squadracorsepolito/SCanner/(threads)

Thread 1 (2024-04-12):

Hardware issues to be fixed in v1

federico-carbone, 2024-04-12:
- [x] pulldown BOOT0
- [x] fix VCAP connections to the uC
- [x] fix nINTSEL selection for LAN8742AI (section 3.8.1.6, nINTSEL=0)
- [x] rotate 180° the SD slot
- [x] fix placement of eth connector (must be more external)
- [x] self-kill mosfet not working (cannot be controlled with 3v3)

Closed 2024-05-06.
