squadracorsepolito/SCanner/docs/schematics_v1.pdf

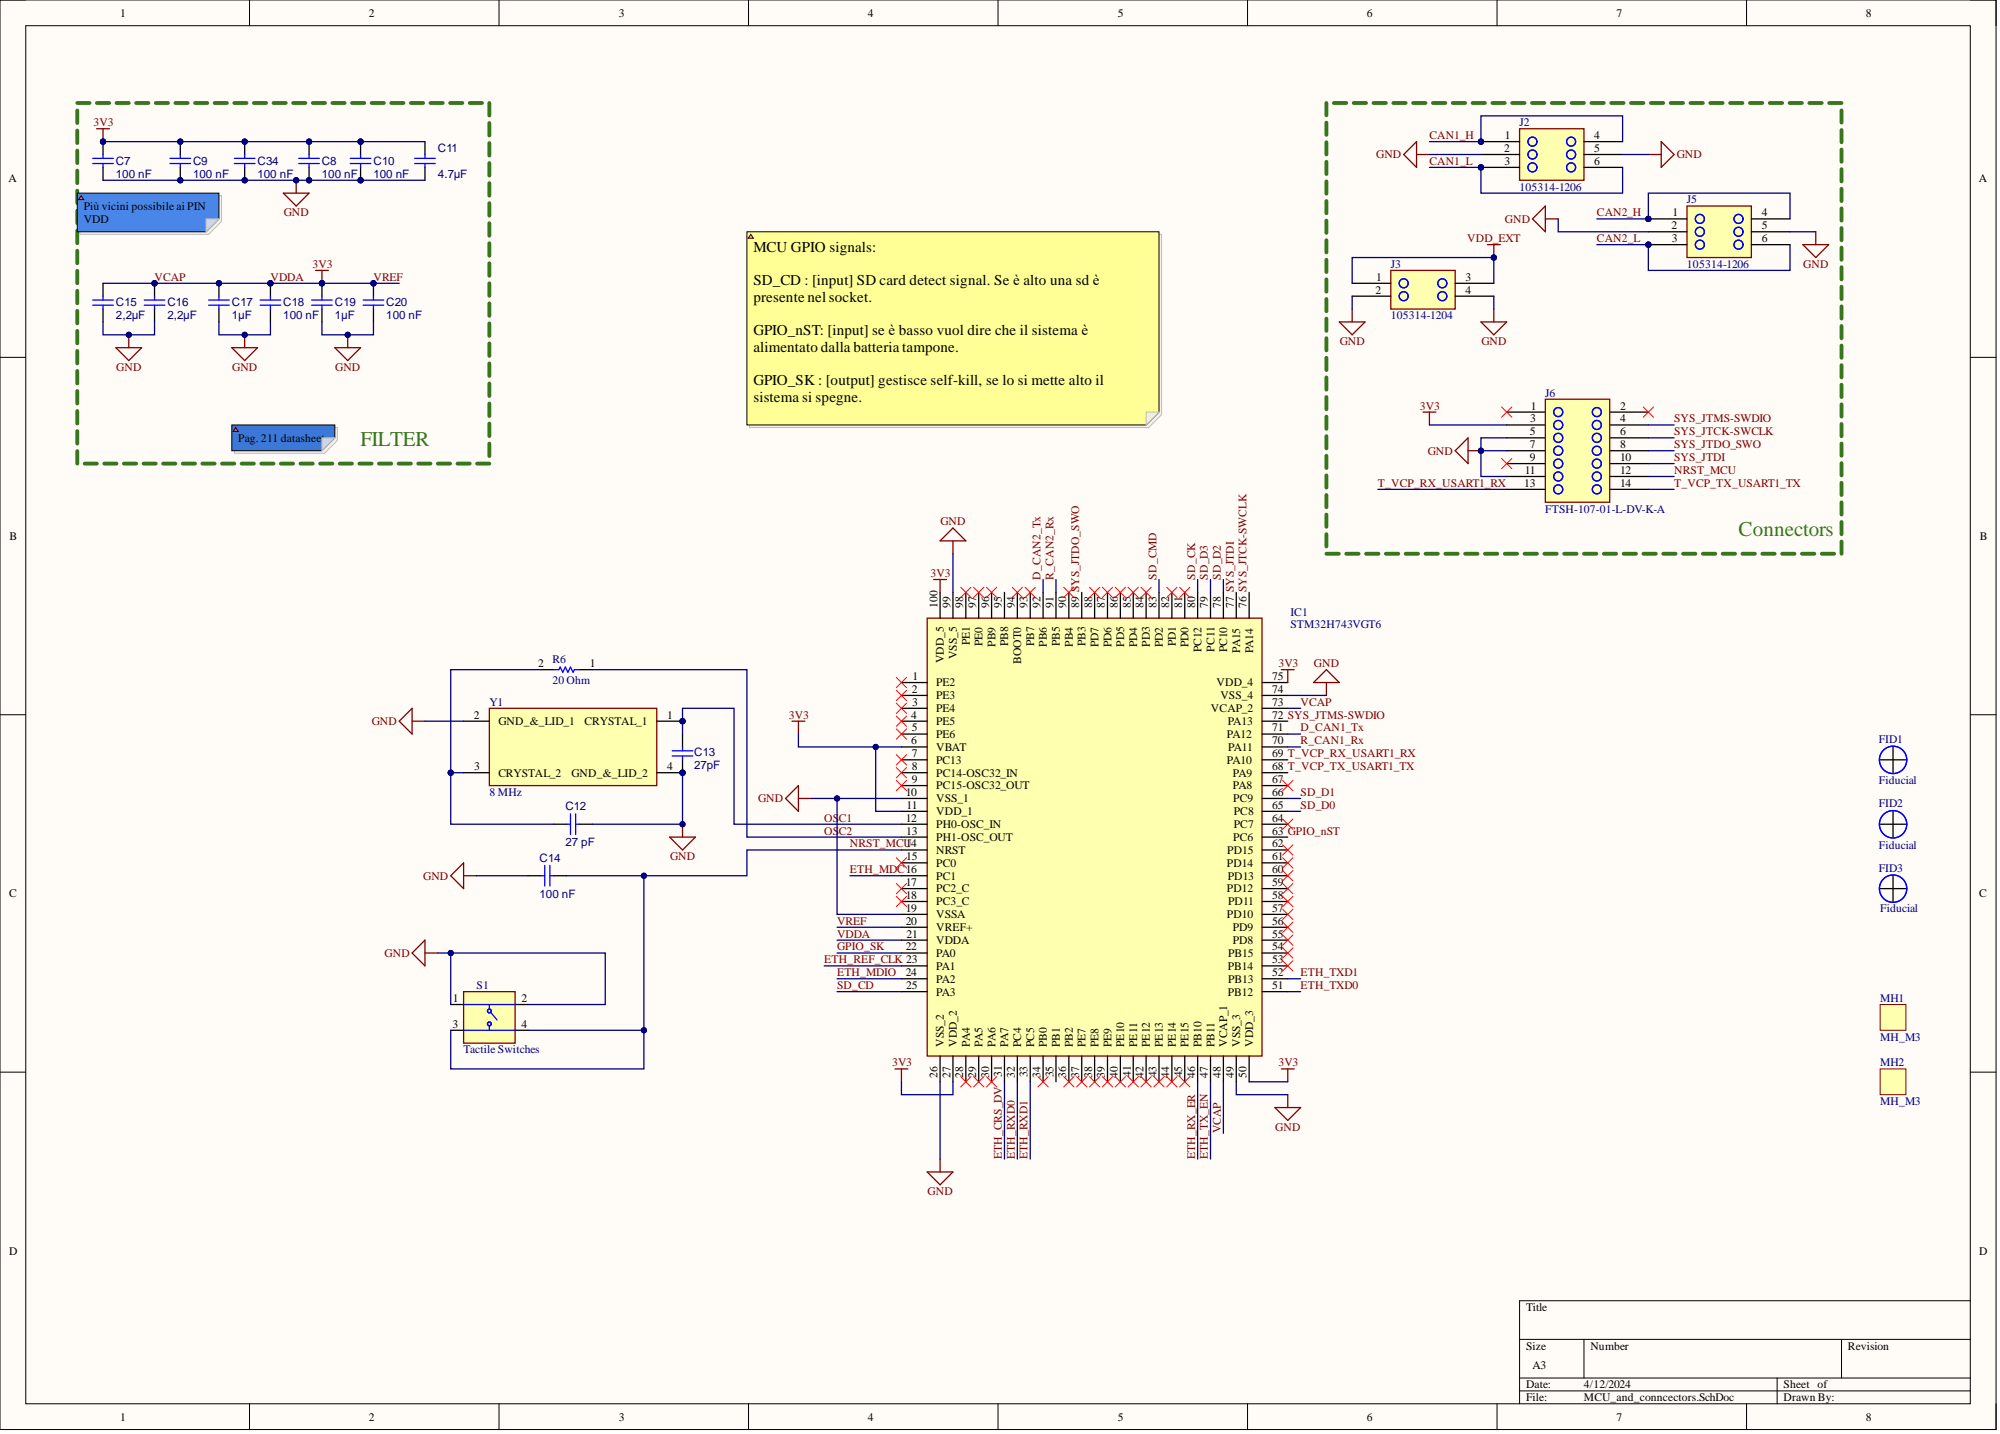
[picture p1: page 1]

Più vicini possibile ai PIN
VDD

SD_CD : [input] SD card detect signal. Se è alto una sd è
presente nel socket.

GPIO_nST: [input] se è basso vuol dire che il sistema è
alimentato dalla batteria tampone.

GPIO_SK : [output] gestisce self-kill, se lo si mette alto il
sistema si spegne.

VDD_1 11

OSC2 | | PH1-OSC_OUT 13
NRST_MCU | NRST 14

GND | ETH_MDC | | PC0 15

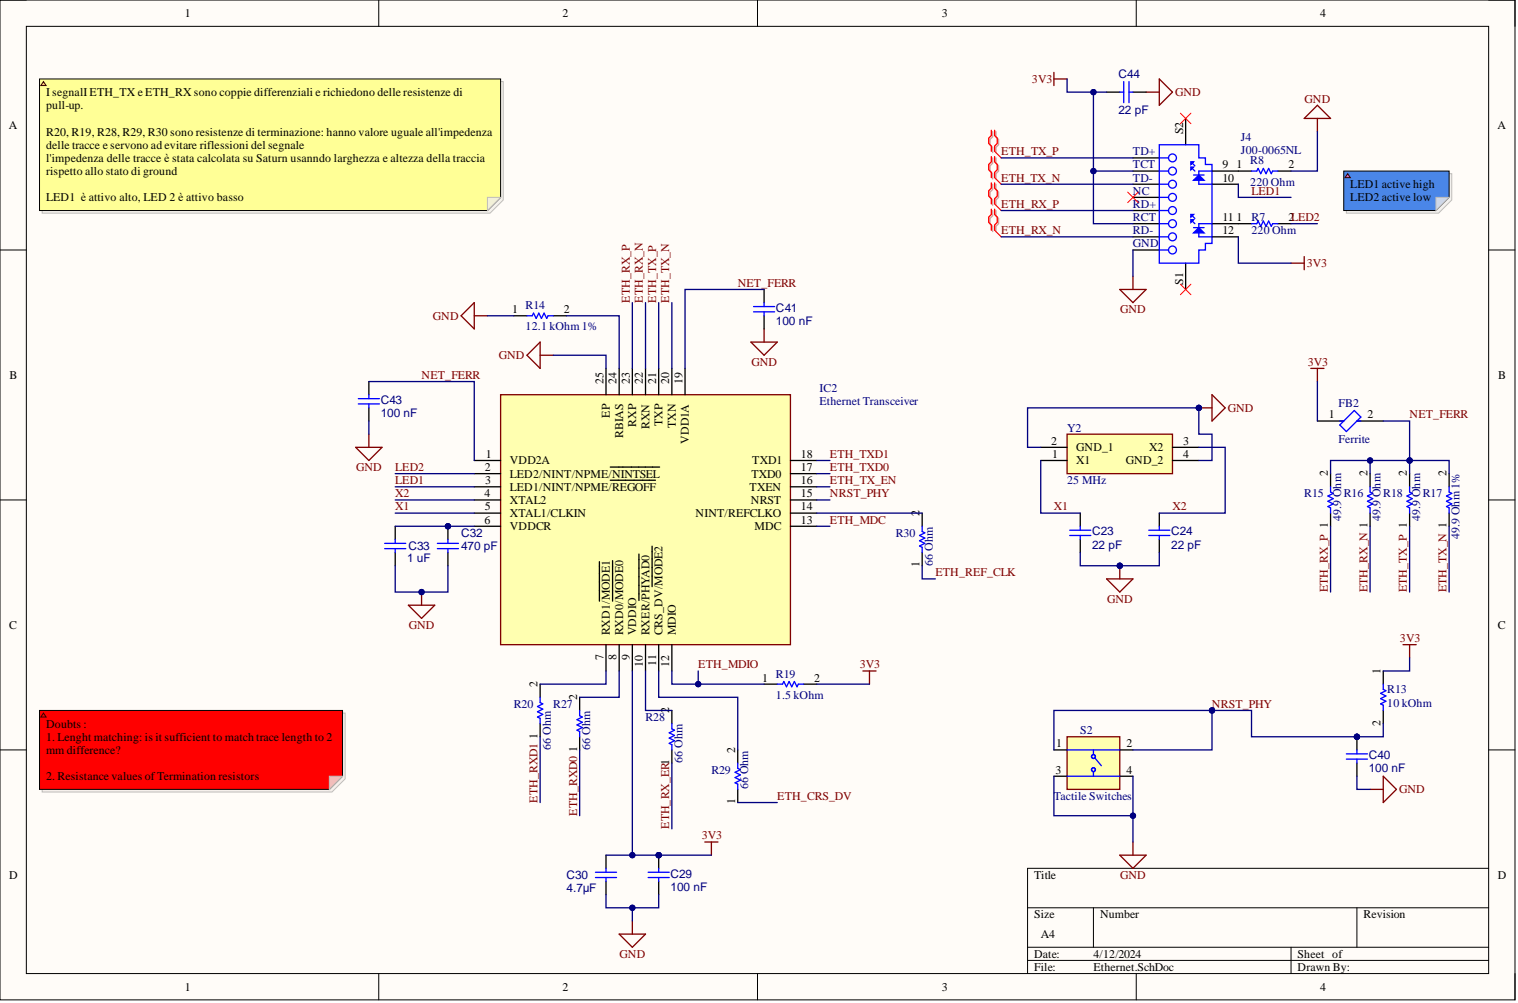
[picture p2: page 2]

I segnalI ETH_TX e ETH_RX sono coppie differenziali e richiedono delle resistenze di
pull-up.

R20, R19, R28, R29, R30 sono resistenze di terminazione: hanno valore uguale all'impedenza
delle tracce e servono ad evitare riflessioni delsegnale
l'impedenza delle tracce è stata calcolata su Saturn usanndo larghezza e altezza della traccia
rispetto allo stato di ground

LED1 è attivo alto, LED 2 è attivo basso

LED1

Doubts :
1. Lenght matching: is it sufficient to match trace length to 2
mm difference?

2. Resistance values of Termination resistors

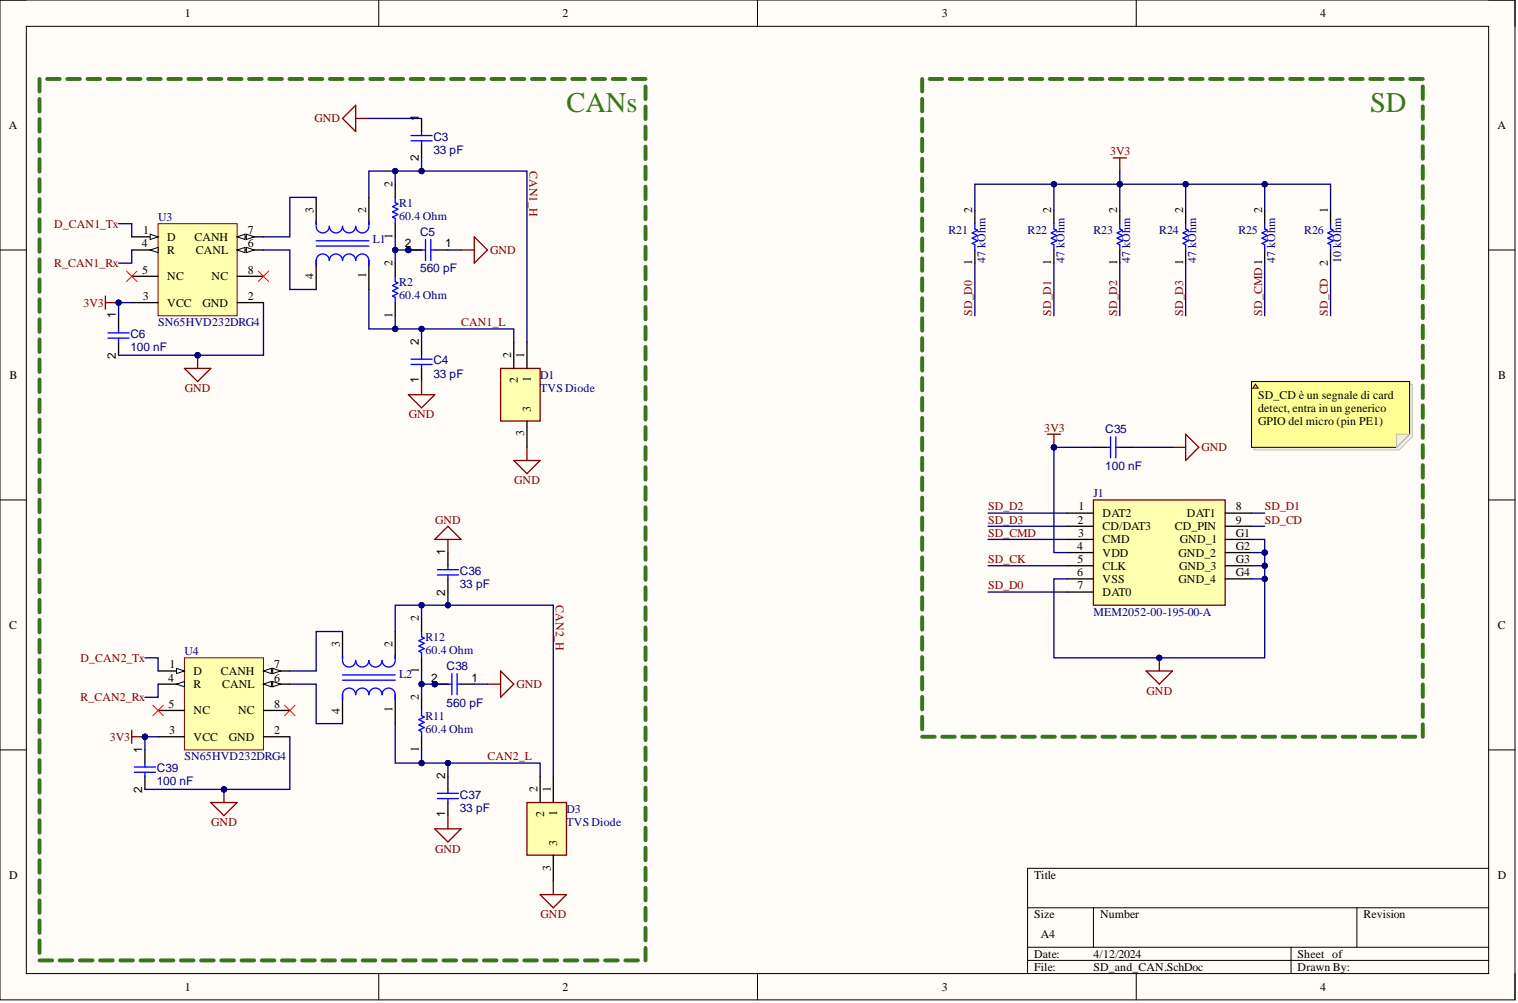
[picture p3: page 3]
47 kOhm; 10 kOhm; 6 CANH; CANs; SD GND C35; i card; detect, en del micro (p

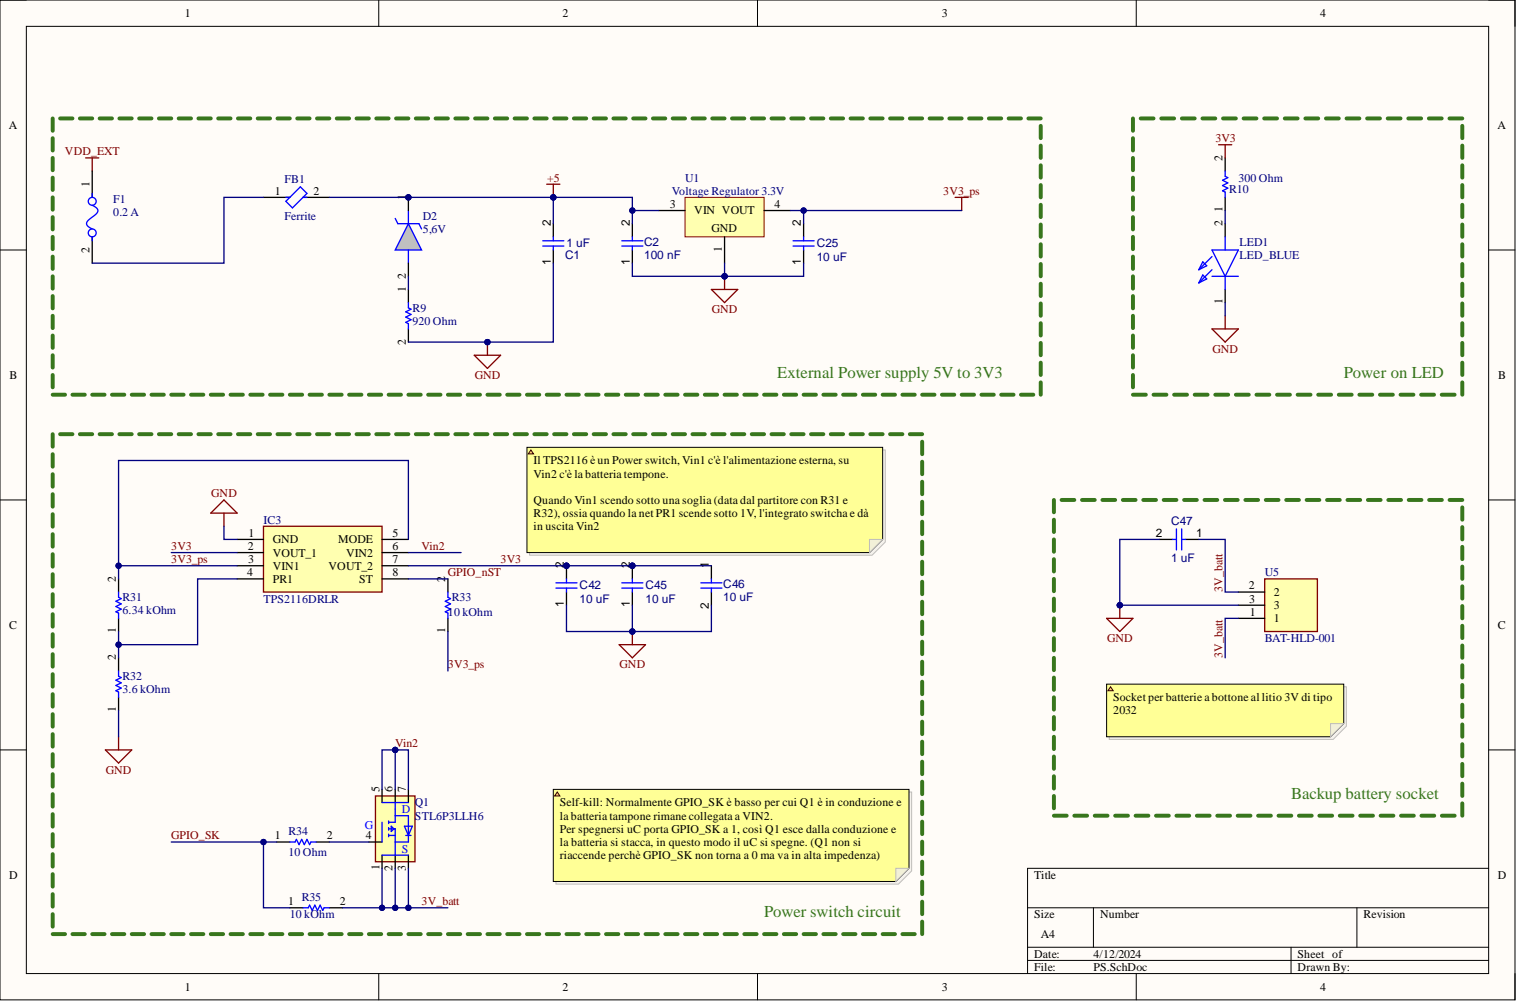
[picture p4: page 4]

Il TPS2116 è un Power switch, Vin1 c'è l'alimentazione esterna, su
Vin2 c'è la batteria tempone.

Quando Vin1 scendo sotto una soglia (data dal partitore con R31 e
R32), ossia quando la net PR1 scende sotto 1V, l'integrato switcha e dà
in uscita Vin2

Socket per batterie a bottone al litio 3V di tipo

Self-kill: Normalmente GPIO_SK è basso per cui Q1 è in conduzione e
la batteria tampone rimane collegata a VIN2.
Per spegnersi uC porta GPIO_SK a 1, così Q1 esce dalla conduzione e
la batteria si stacca, in questo modo il uC si spegne. (Q1 non si
riaccende perchè GPIO_SK non torna a 0 ma va in alta impedenza)

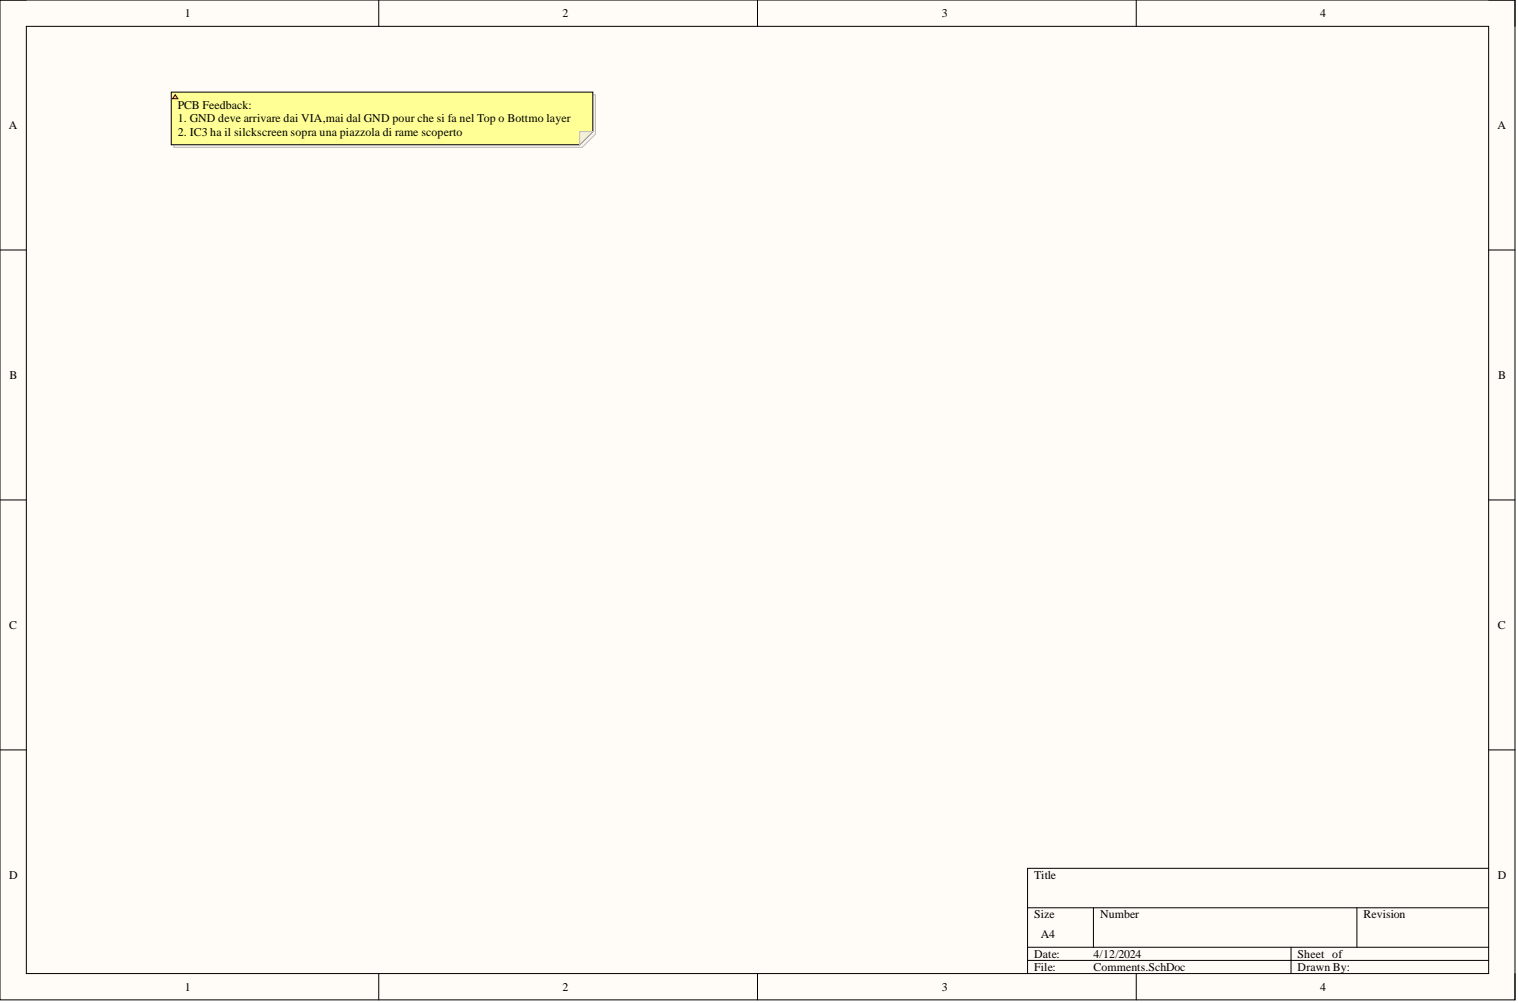
[picture p5: page 5]
File:; Comments.SchDoc; Drawn By:

PCB Feedback:
1. GND deve arrivare dai VIA,mai dal GND pour che si fa nel Top o Bottmo layer
2. IC3 ha il silckscreen sopra una piazzola di rame scoperto
