squadracorsepolito/SCanner/Core/Inc/main.h

#define LWIP_Init_Done 0x1
#define SDCARD_Init_Done 0x2
#define SELF_KILL_Pin GPIO_PIN_0
#define SELF_KILL_GPIO_Port GPIOA
#define SD_DET_Pin GPIO_PIN_3
#define SD_DET_GPIO_Port GPIOA
#define nRST_PHY_GPIO_OUT_Pin GPIO_PIN_15
#define nRST_PHY_GPIO_OUT_GPIO_Port GPIOB
#define GPIO_nST_Pin GPIO_PIN_6
#define GPIO_nST_GPIO_Port GPIOC
#define GPIO_nST_EXTI_IRQn EXTI9_5_IRQn
