squadracorsepolito/SCanner/Core/Src/fdcan.c

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
/* Includes ------------------------------------------------------------------*/
#include "fdcan.h"

FDCAN_HandleTypeDef hfdcan1;
FDCAN_HandleTypeDef hfdcan2;

/* FDCAN1 init function */
void MX_FDCAN1_Init(void)
{

  hfdcan1.Instance = FDCAN1;
  hfdcan1.Init.FrameFormat = FDCAN_FRAME_CLASSIC;
  hfdcan1.Init.Mode = FDCAN_MODE_BUS_MONITORING;
  hfdcan1.Init.AutoRetransmission = DISABLE;
  hfdcan1.Init.TransmitPause = DISABLE;
  hfdcan1.Init.ProtocolException = DISABLE;
  hfdcan1.Init.NominalPrescaler = 1;
  hfdcan1.Init.NominalSyncJumpWidth = 13;
  hfdcan1.Init.NominalTimeSeg1 = 86;
  hfdcan1.Init.NominalTimeSeg2 = 13;
  hfdcan1.Init.DataPrescaler = 10;
  hfdcan1.Init.DataSyncJumpWidth = 1;
  hfdcan1.Init.DataTimeSeg1 = 8;
  hfdcan1.Init.DataTimeSeg2 = 1;
  hfdcan1.Init.MessageRAMOffset = 0;
  hfdcan1.Init.StdFiltersNbr = 1;
  hfdcan1.Init.ExtFiltersNbr = 0;
  hfdcan1.Init.RxFifo0ElmtsNbr = 64;
  hfdcan1.Init.RxFifo0ElmtSize = FDCAN_DATA_BYTES_8;
  hfdcan1.Init.RxFifo1ElmtsNbr = 0;
  hfdcan1.Init.RxFifo1ElmtSize = FDCAN_DATA_BYTES_8;
  hfdcan1.Init.RxBuffersNbr = 0;
  hfdcan1.Init.RxBufferSize = FDCAN_DATA_BYTES_8;
  hfdcan1.Init.TxEventsNbr = 0;
  hfdcan1.Init.TxBuffersNbr = 0;
  hfdcan1.Init.TxFifoQueueElmtsNbr = 32;
  hfdcan1.Init.TxFifoQueueMode = FDCAN_TX_FIFO_OPERATION;
  hfdcan1.Init.TxElmtSize = FDCAN_DATA_BYTES_8;
  if (HAL_FDCAN_Init(&hfdcan1) != HAL_OK)
  {
    Error_Handler();
  }
}
/* FDCAN2 init function */
void MX_FDCAN2_Init(void)
{

  hfdcan2.Instance = FDCAN2;
  hfdcan2.Init.FrameFormat = FDCAN_FRAME_CLASSIC;
  hfdcan2.Init.Mode = FDCAN_MODE_BUS_MONITORING;
  hfdcan2.Init.AutoRetransmission = DISABLE;
  hfdcan2.Init.TransmitPause = DISABLE;
  hfdcan2.Init.ProtocolException = DISABLE;
  hfdcan2.Init.NominalPrescaler = 1;
  hfdcan2.Init.NominalSyncJumpWidth = 1;
  hfdcan2.Init.NominalTimeSeg1 = 86;
  hfdcan2.Init.NominalTimeSeg2 = 13;
  hfdcan2.Init.DataPrescaler = 10;
  hfdcan2.Init.DataSyncJumpWidth = 1;
  hfdcan2.Init.DataTimeSeg1 = 8;
  hfdcan2.Init.DataTimeSeg2 = 1;
  hfdcan2.Init.MessageRAMOffset = 385;
  hfdcan2.Init.StdFiltersNbr = 1;
  hfdcan2.Init.ExtFiltersNbr = 0;
  hfdcan2.Init.RxFifo0ElmtsNbr = 0;
  hfdcan2.Init.RxFifo0ElmtSize = FDCAN_DATA_BYTES_8;
  hfdcan2.Init.RxFifo1ElmtsNbr = 64;
  hfdcan2.Init.RxFifo1ElmtSize = FDCAN_DATA_BYTES_8;
  hfdcan2.Init.RxBuffersNbr = 0;
  hfdcan2.Init.RxBufferSize = FDCAN_DATA_BYTES_8;
  hfdcan2.Init.TxEventsNbr = 0;
  hfdcan2.Init.TxBuffersNbr = 0;
  hfdcan2.Init.TxFifoQueueElmtsNbr = 32;
  hfdcan2.Init.TxFifoQueueMode = FDCAN_TX_FIFO_OPERATION;
  hfdcan2.Init.TxElmtSize = FDCAN_DATA_BYTES_8;
  if (HAL_FDCAN_Init(&hfdcan2) != HAL_OK)
  {
    Error_Handler();
  }
}

static uint32_t HAL_RCC_FDCAN_CLK_ENABLED=0;

void HAL_FDCAN_MspInit(FDCAN_HandleTypeDef* fdcanHandle)
{

  GPIO_InitTypeDef GPIO_InitStruct = {0};
  RCC_PeriphCLKInitTypeDef PeriphClkInitStruct = {0};
  if(fdcanHandle->Instance==FDCAN1)
  {
  /** Initializes the peripherals clock
  */
    PeriphClkInitStruct.PeriphClockSelection = RCC_PERIPHCLK_FDCAN;
    PeriphClkInitStruct.FdcanClockSelection = RCC_FDCANCLKSOURCE_PLL;
    if (HAL_RCCEx_PeriphCLKConfig(&PeriphClkInitStruct) != HAL_OK)
    {
      Error_Handler();
    }

    /* FDCAN1 clock enable */
    HAL_RCC_FDCAN_CLK_ENABLED++;
    if(HAL_RCC_FDCAN_CLK_ENABLED==1){
      __HAL_RCC_FDCAN_CLK_ENABLE();
    }

    __HAL_RCC_GPIOA_CLK_ENABLE();
    /**FDCAN1 GPIO Configuration
    PA11     ------> FDCAN1_RX
    PA12     ------> FDCAN1_TX
    */
    GPIO_InitStruct.Pin = GPIO_PIN_11|GPIO_PIN_12;
    GPIO_InitStruct.Mode = GPIO_MODE_AF_PP;
    GPIO_InitStruct.Pull = GPIO_NOPULL;
    GPIO_InitStruct.Speed = GPIO_SPEED_FREQ_LOW;
    GPIO_InitStruct.Alternate = GPIO_AF9_FDCAN1;
    HAL_GPIO_Init(GPIOA, &GPIO_InitStruct);

    /* FDCAN1 interrupt Init */
    HAL_NVIC_SetPriority(FDCAN1_IT0_IRQn, 5, 0);
    HAL_NVIC_EnableIRQ(FDCAN1_IT0_IRQn);
    HAL_NVIC_SetPriority(FDCAN1_IT1_IRQn, 5, 0);
    HAL_NVIC_EnableIRQ(FDCAN1_IT1_IRQn);
    HAL_NVIC_SetPriority(FDCAN_CAL_IRQn, 5, 0);
    HAL_NVIC_EnableIRQ(FDCAN_CAL_IRQn);
  }
  else if(fdcanHandle->Instance==FDCAN2)
  {
  /** Initializes the peripherals clock
  */
    PeriphClkInitStruct.PeriphClockSelection = RCC_PERIPHCLK_FDCAN;
    PeriphClkInitStruct.FdcanClockSelection = RCC_FDCANCLKSOURCE_PLL;
    if (HAL_RCCEx_PeriphCLKConfig(&PeriphClkInitStruct) != HAL_OK)
    {
      Error_Handler();
    }

    /* FDCAN2 clock enable */
    HAL_RCC_FDCAN_CLK_ENABLED++;
    if(HAL_RCC_FDCAN_CLK_ENABLED==1){
      __HAL_RCC_FDCAN_CLK_ENABLE();
    }

    __HAL_RCC_GPIOB_CLK_ENABLE();
    /**FDCAN2 GPIO Configuration
    PB5     ------> FDCAN2_RX
    PB6     ------> FDCAN2_TX
    */
    GPIO_InitStruct.Pin = GPIO_PIN_5|GPIO_PIN_6;
    GPIO_InitStruct.Mode = GPIO_MODE_AF_PP;
    GPIO_InitStruct.Pull = GPIO_NOPULL;
    GPIO_InitStruct.Speed = GPIO_SPEED_FREQ_LOW;
    GPIO_InitStruct.Alternate = GPIO_AF9_FDCAN2;
    HAL_GPIO_Init(GPIOB, &GPIO_InitStruct);

    /* FDCAN2 interrupt Init */
    HAL_NVIC_SetPriority(FDCAN2_IT0_IRQn, 5, 0);
    HAL_NVIC_EnableIRQ(FDCAN2_IT0_IRQn);
    HAL_NVIC_SetPriority(FDCAN2_IT1_IRQn, 5, 0);
    HAL_NVIC_EnableIRQ(FDCAN2_IT1_IRQn);
    HAL_NVIC_SetPriority(FDCAN_CAL_IRQn, 5, 0);
    HAL_NVIC_EnableIRQ(FDCAN_CAL_IRQn);
  }
}

void HAL_FDCAN_MspDeInit(FDCAN_HandleTypeDef* fdcanHandle)
{

  if(fdcanHandle->Instance==FDCAN1)
  {
    /* Peripheral clock disable */
    HAL_RCC_FDCAN_CLK_ENABLED--;
    if(HAL_RCC_FDCAN_CLK_ENABLED==0){
      __HAL_RCC_FDCAN_CLK_DISABLE();
    }

    /**FDCAN1 GPIO Configuration
    PA11     ------> FDCAN1_RX
    PA12     ------> FDCAN1_TX
    */
    HAL_GPIO_DeInit(GPIOA, GPIO_PIN_11|GPIO_PIN_12);

    /* FDCAN1 interrupt Deinit */
    HAL_NVIC_DisableIRQ(FDCAN1_IT0_IRQn);
    HAL_NVIC_DisableIRQ(FDCAN1_IT1_IRQn);
  /* USER CODE BEGIN FDCAN1:FDCAN_CAL_IRQn disable */
    /**
    * Uncomment the line below to disable the "FDCAN_CAL_IRQn" interrupt
    * Be aware, disabling shared interrupt may affect other IPs
    */
    /* HAL_NVIC_DisableIRQ(FDCAN_CAL_IRQn); */
  /* USER CODE END FDCAN1:FDCAN_CAL_IRQn disable */

  }
  else if(fdcanHandle->Instance==FDCAN2)
  {
    /* Peripheral clock disable */
    HAL_RCC_FDCAN_CLK_ENABLED--;
    if(HAL_RCC_FDCAN_CLK_ENABLED==0){
      __HAL_RCC_FDCAN_CLK_DISABLE();
    }

    /**FDCAN2 GPIO Configuration
    PB5     ------> FDCAN2_RX
    PB6     ------> FDCAN2_TX
    */
    HAL_GPIO_DeInit(GPIOB, GPIO_PIN_5|GPIO_PIN_6);

    /* FDCAN2 interrupt Deinit */
    HAL_NVIC_DisableIRQ(FDCAN2_IT0_IRQn);
    HAL_NVIC_DisableIRQ(FDCAN2_IT1_IRQn);
  /* USER CODE BEGIN FDCAN2:FDCAN_CAL_IRQn disable */
    /**
    * Uncomment the line below to disable the "FDCAN_CAL_IRQn" interrupt
    * Be aware, disabling shared interrupt may affect other IPs
    */
    /* HAL_NVIC_DisableIRQ(FDCAN_CAL_IRQn); */
  /* USER CODE END FDCAN2:FDCAN_CAL_IRQn disable */

  }
}
