squadracorsepolito/SCanner/(commit log)

2024-04-12 chore: added v1 schematic
2024-04-12 updated stm32cubemx
2024-04-25 feat: CANbus working
2024-07-08 fix: initialization issue solved
    [SCanner.ioc, blt_conf.h, bootloader.ioc, can.c, can_task.c, can_task.h, fdcan.c]
2024-08-01 feat: implemented self-kill for new pcb
2024-10-01 chore: trying to fix timestamp issue
    [can_task.c, sdcard_task.c]
2024-10-01 fix: higher sdcard priority and bigger queue
    [SCanner.ioc, sdcard_task.c]
