squadracorsepolito/SCanner/(notices)

Notices in the files:
Bootloader/bootloader/Core/Inc/boot_core/blt_conf.h:
modify it under the terms of the GNU General Public License as published by the Free
Core/Src/fdcan.c:
Copyright (c) 2024 STMicroelectronics.
All rights reserved.
This software is licensed under terms that can be found in the LICENSE file
